simtind/ergoducks/keyboard-layout.png

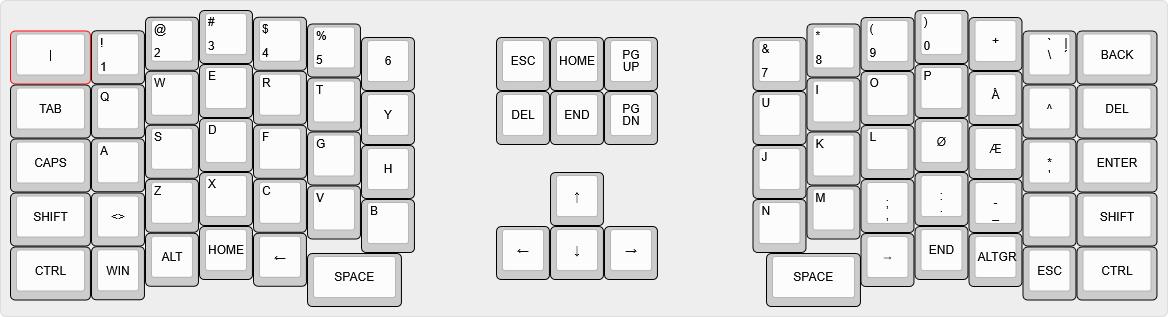
keyboard-layout.png
