simtind/ergoducks/hardware/controller/ergoducks.step

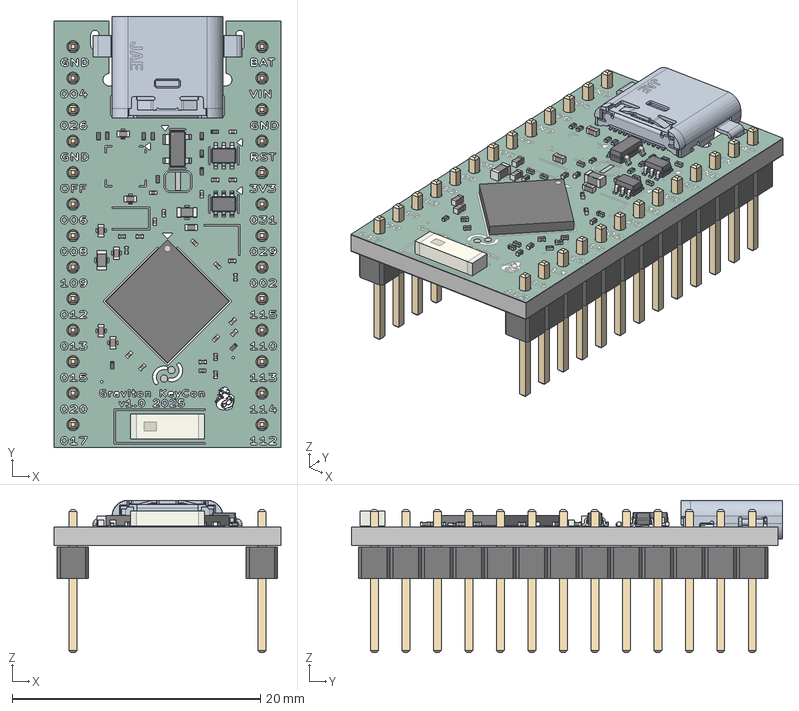
[picture p2: CAD file, 2025-09-15]
hardware/controller/ergoducks.step
18.3 x 34.8 x 12.3 mm
R_0201_0603Metric x 11
C_0201_0603Metric x 20
C_0402_1005Metric x 6
L_0603_1608Metric x 2
L_0201_0603Metric x 3
SOT-363_SC-70-6 x 2
Johanson_2450AT43F0100
SOT-143
Nordic_AQFN-73-1EP_7x7mm_P0.5mm
L_0402_1005Metric
dx07b024jj1r1500
PinHeader_1x13_P2.54mm_Vertical x 2
ergoducks_controller_silkscreen
ergoducks_controller_soldermask
ergoducks_controller_PCB
