simtind/ergoducks/hardware/keyboard_right/ergoducks_keyboard_right.kicad_pcb

## KiCad design hardware/keyboard_right/ergoducks_keyboard_right.kicad_pcb (2025-12-31)

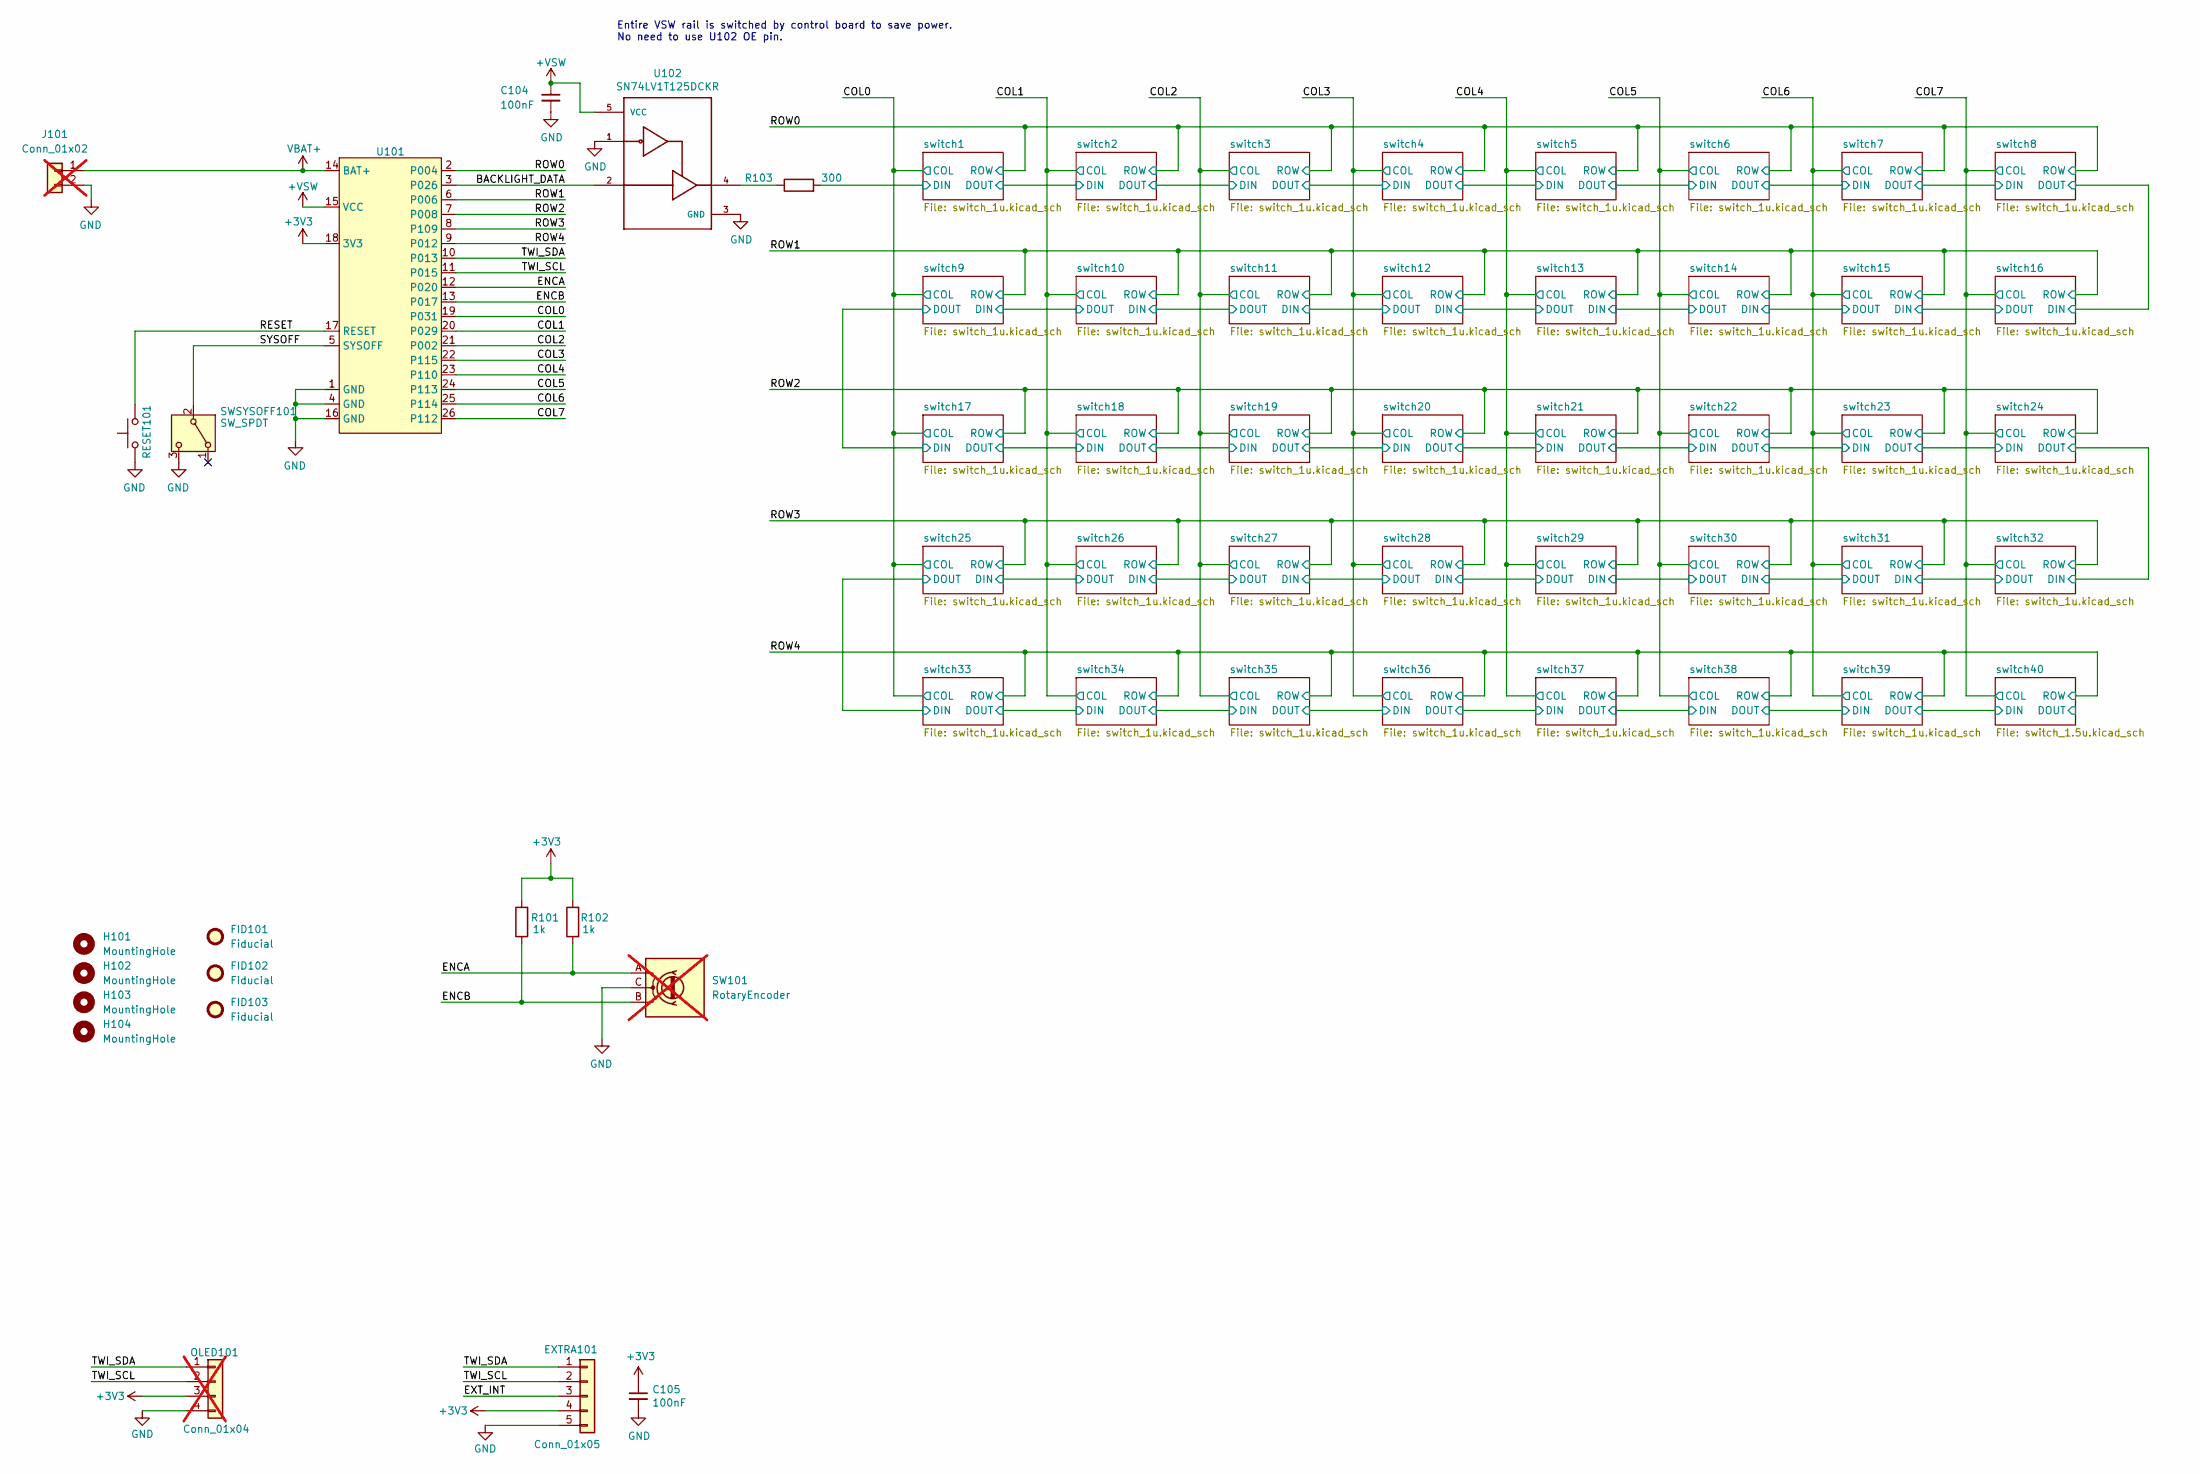
[picture p43: schematic ergoducks_keyboard_right.kicad_sch, ErgoDucks]

Parts:
C104, C105: 100nF; C_0402_1005Metric; Mouser partno 187-CL10B104JB8NNNC
EXTRA101: Conn_01x05; PinHeader_1x05_P2.54mm_Vertical
FID101, FID102, FID103: Fiducial; Fiducial_0.5mm_Mask1mm
H101, H102, H103, H104: MountingHole; MountingHole_2.2mm_M2
J101: Conn_01x02; JST_PH_S2B-PH-K_1x02_P2.00mm_Horizontal; not fitted
OLED101: Conn_01x04; PinHeader_1x04_P2.54mm_Vertical; not fitted
R101, R102: 1k; R_0603_1608Metric_Pad0.98x0.95mm_HandSolder; Mouser partno 667-ERJ-H3ED3000V
R103: 300; R_0603_1608Metric_Pad0.98x0.95mm_HandSolder; Mouser partno 667-ERJ-H3ED3000V
RESET101: SW_Push; SW_SPST_B3U-1000P-B; LCSC C561515
SW101: RotaryEncoder; RotaryEncoder_Alps_EC11E-Switch_Vertical_H20mm_MountingHoles; not fitted
SWSYSOFF101: SW_SPDT; SW_SPDT_CK_JS102011SAQN; LCSC C221660
U101: graviton-keycon
U102: SN74LV1T125DCKR; SOT-23-5; Mouser partno 595-SN74LV1T125DCKR

Connections:
+3V3: C105.1, EXTRA101.4, OLED101.3, R101.2, R102.2, U101.18 (3V3)
+VSW: C104.1, U101.15 (VCC), U102.5 (VCC); also elsewhere on the board
/BACKLIGHT_DATA: U101.3 (P026), U102.2
/COL0: U101.19 (P031); also elsewhere on the board
/COL1: U101.20 (P029); also elsewhere on the board
/COL2: U101.21 (P002); also elsewhere on the board
/COL3: U101.22 (P115); also elsewhere on the board
/COL4: U101.23 (P110); also elsewhere on the board
/COL5: U101.24 (P113); also elsewhere on the board
/COL6: U101.25 (P114); also elsewhere on the board
/COL7: U101.26 (P112); also elsewhere on the board
/ENCA: R102.1, SW101.A, U101.12 (P020)
/ENCB: R101.1, SW101.B, U101.13 (P017)
/EXT_INT: EXTRA101.3
/RESET: RESET101.1, U101.17 (RESET)
/ROW0: U101.2 (P004); also elsewhere on the board
/ROW1: U101.6; also elsewhere on the board
/ROW2: U101.7 (P008); also elsewhere on the board
/ROW3: U101.8 (P109); also elsewhere on the board
/ROW4: U101.9 (P012); also elsewhere on the board
/SYSOFF: SWSYSOFF101.2 (B), U101.5 (SYSOFF)
/TWI_SCL: EXTRA101.2, OLED101.2, U101.11 (P015)
/TWI_SDA: EXTRA101.1, OLED101.1, U101.10 (P013)
/switch1/DIN: R103.2; also elsewhere on the board
GND: C104.2, C105.2, EXTRA101.5, J101.2, OLED101.4, RESET101.2, SW101.C, SWSYSOFF101.3 (C), U101.1 (GND), U101.4 (GND), U101.16 (GND), U102.1, U102.3 (GND); also elsewhere on the board
unnamed: R103.1, U102.4
VBAT+: J101.1, U101.14 (BAT+)

Notes on the sheet:
Entire VSW rail is switched by control board to save power. No need to use U102 OE pin.

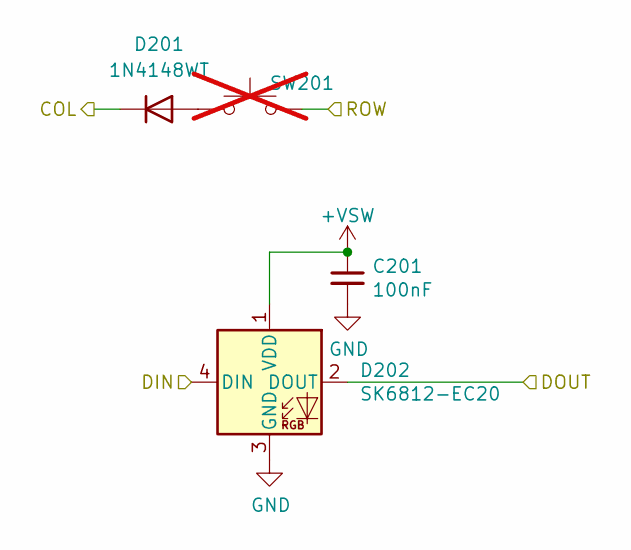
[picture p44: schematic switch_1u.kicad_sch]

Parts:
C201: 100nF; C_0402_1005Metric; Mouser partno 187-CL10B104JB8NNNC
D201: 1N4148WT; D_SOD-523; LCSC C27748
D202: SK6812-EC20; sk6812-ec20; Digikey partno 1528-4960-ND
SW201: SW_Hotswap_Kailh_Choc_V1V2_1.00u; Mouser partno 540-MX1A-G1NA; not fitted

Connections:
+VSW: C201.1, D202.1 (VDD); also elsewhere on the board
/COL0: D201.1 (K); also elsewhere on the board
/ROW0: SW201.2; also elsewhere on the board
/switch1/DIN: D202.4 (DIN); also elsewhere on the board
/switch1/DOUT: D202.2 (DOUT); also elsewhere on the board
GND: C201.2, D202.3 (GND); also elsewhere on the board
unnamed: D201.2 (A), SW201.1

Parts of its further copies:
C301, C401, C501, C601, C701, C801, C901, C1001, C1101, C1201, C1301, C1401, C1501, C1601, C1701, C1801, C1901, C2001, C2101, C2201, C2301, C2401, C2501, C2601, C2701, C2801, C2901, C3001, C3101, C3201, C3301, C3401, C3501, C3601, C3701, C3801, C3901, C4001: 100nF; C_0402_1005Metric; Mouser partno 187-CL10B104JB8NNNC
D301, D401, D501, D601, D701, D801, D901, D1001, D1101, D1201, D1301, D1401, D1501, D1601, D1701, D1801, D1901, D2001, D2101, D2201, D2301, D2401, D2501, D2601, D2701, D2801, D2901, D3001, D3101, D3201, D3301, D3401, D3501, D3601, D3701, D3801, D3901, D4001: 1N4148WT; D_SOD-523; LCSC C27748
D302, D402, D502, D602, D702, D802, D902, D1002, D1102, D1202, D1302, D1402, D1502, D1602, D1702, D1802, D1902, D2002, D2102, D2202, D2302, D2402, D2502, D2602, D2702, D2802, D2902, D3002, D3102, D3202, D3302, D3402, D3502, D3602, D3702, D3802, D3902, D4002: SK6812-EC20; sk6812-ec20; Digikey partno 1528-4960-ND
SW301, SW401, SW501, SW601, SW701, SW801, SW901, SW1001, SW1101, SW1201, SW1301, SW1401, SW1501, SW1601, SW1701, SW1801, SW1901, SW2001, SW2101, SW2201, SW2301, SW2401, SW2501, SW2601, SW2701, SW2801, SW2901, SW3001, SW3101, SW3201, SW3301, SW3401, SW3501, SW3601, SW3701, SW3801, SW3901, SW4001: SW_Hotswap_Kailh_Choc_V1V2_1.00u; Mouser partno 540-MX1A-G1NA; not fitted

Connections of its further copies:
+VSW: C301.1, C401.1, C501.1, C601.1, C701.1, C801.1, C901.1, C1001.1, C1101.1, C1201.1, C1301.1, C1401.1, C1501.1, C1601.1, C1701.1, C1801.1, C1901.1, C2001.1, C2101.1, C2201.1, C2301.1, C2401.1, C2501.1, C2601.1, C2701.1, C2801.1, C2901.1, C3001.1, C3101.1, C3201.1, C3301.1, C3401.1, C3501.1, C3601.1, C3701.1, C3801.1, C3901.1, C4001.1, D302.1 (VDD), D402.1 (VDD), D502.1 (VDD), D602.1 (VDD), D702.1 (VDD), D802.1 (VDD), D902.1 (VDD), D1002.1 (VDD), D1102.1 (VDD), D1202.1 (VDD), D1302.1 (VDD), D1402.1 (VDD), D1502.1 (VDD), D1602.1 (VDD), D1702.1 (VDD), D1802.1 (VDD), D1902.1 (VDD), D2002.1 (VDD), D2102.1 (VDD), D2202.1 (VDD), D2302.1 (VDD), D2402.1 (VDD), D2502.1 (VDD), D2602.1 (VDD), D2702.1 (VDD), D2802.1 (VDD), D2902.1 (VDD), D3002.1 (VDD), D3102.1 (VDD), D3202.1 (VDD), D3302.1 (VDD), D3402.1 (VDD), D3502.1 (VDD), D3602.1 (VDD), D3702.1 (VDD), D3802.1 (VDD), D3902.1 (VDD), D4002.1 (VDD); also elsewhere on the board
/COL0: D1001.1 (K), D1801.1 (K), D2601.1 (K), D3401.1 (K); also elsewhere on the board
/COL1: D301.1 (K), D1101.1 (K), D1901.1 (K), D2701.1 (K), D3501.1 (K); also elsewhere on the board
/COL2: D401.1 (K), D1201.1 (K), D2001.1 (K), D2801.1 (K), D3601.1 (K); also elsewhere on the board
/COL3: D501.1 (K), D1301.1 (K), D2101.1 (K), D2901.1 (K), D3701.1 (K); also elsewhere on the board
/COL4: D601.1 (K), D1401.1 (K), D2201.1 (K), D3001.1 (K), D3801.1 (K); also elsewhere on the board
/COL5: D701.1 (K), D1501.1 (K), D2301.1 (K), D3101.1 (K), D3901.1 (K); also elsewhere on the board
/COL6: D801.1 (K), D1601.1 (K), D2401.1 (K), D3201.1 (K), D4001.1 (K); also elsewhere on the board
/COL7: D901.1 (K), D1701.1 (K), D2501.1 (K), D3301.1 (K); also elsewhere on the board
/ROW0: SW301.2, SW401.2, SW501.2, SW601.2, SW701.2, SW801.2, SW901.2; also elsewhere on the board
/ROW1: SW1001.2, SW1101.2, SW1201.2, SW1301.2, SW1401.2, SW1501.2, SW1601.2, SW1701.2; also elsewhere on the board
/ROW2: SW1801.2, SW1901.2, SW2001.2, SW2101.2, SW2201.2, SW2301.2, SW2401.2, SW2501.2; also elsewhere on the board
/ROW3: SW2601.2, SW2701.2, SW2801.2, SW2901.2, SW3001.2, SW3101.2, SW3201.2, SW3301.2; also elsewhere on the board
/ROW4: SW3401.2, SW3501.2, SW3601.2, SW3701.2, SW3801.2, SW3901.2, SW4001.2; also elsewhere on the board
/switch1/DOUT: D302.4 (DIN); also elsewhere on the board
/switch2/DOUT: D302.2 (DOUT), D402.4 (DIN)
/switch3/DOUT: D402.2 (DOUT), D502.4 (DIN)
/switch4/DOUT: D502.2 (DOUT), D602.4 (DIN)
/switch5/DOUT: D602.2 (DOUT), D702.4 (DIN)
/switch6/DOUT: D702.2 (DOUT), D802.4 (DIN)
/switch7/DOUT: D802.2 (DOUT), D902.4 (DIN)
/switch10/DIN: D1102.4 (DIN), D1202.2 (DOUT)
/switch10/DOUT: D1002.4 (DIN), D1102.2 (DOUT)
/switch11/DIN: D1202.4 (DIN), D1302.2 (DOUT)
/switch12/DIN: D1302.4 (DIN), D1402.2 (DOUT)
/switch13/DIN: D1402.4 (DIN), D1502.2 (DOUT)
/switch14/DIN: D1502.4 (DIN), D1602.2 (DOUT)
/switch15/DIN: D1602.4 (DIN), D1702.2 (DOUT)
/switch16/DIN: D902.2 (DOUT), D1702.4 (DIN)
/switch17/DIN: D1002.2 (DOUT), D1802.4 (DIN)
/switch17/DOUT: D1802.2 (DOUT), D1902.4 (DIN)
/switch18/DOUT: D1902.2 (DOUT), D2002.4 (DIN)
/switch19/DOUT: D2002.2 (DOUT), D2102.4 (DIN)
/switch20/DOUT: D2102.2 (DOUT), D2202.4 (DIN)
/switch21/DOUT: D2202.2 (DOUT), D2302.4 (DIN)
/switch22/DOUT: D2302.2 (DOUT), D2402.4 (DIN)
/switch23/DOUT: D2402.2 (DOUT), D2502.4 (DIN)
/switch24/DOUT: D2502.2 (DOUT), D3302.4 (DIN)
/switch25/DIN: D2602.4 (DIN), D2702.2 (DOUT)
/switch25/DOUT: D2602.2 (DOUT), D3402.4 (DIN)
/switch26/DIN: D2702.4 (DIN), D2802.2 (DOUT)
/switch27/DIN: D2802.4 (DIN), D2902.2 (DOUT)
/switch28/DIN: D2902.4 (DIN), D3002.2 (DOUT)
/switch29/DIN: D3002.4 (DIN), D3102.2 (DOUT)
/switch30/DIN: D3102.4 (DIN), D3202.2 (DOUT)
/switch31/DIN: D3202.4 (DIN), D3302.2 (DOUT)
/switch33/DOUT: D3402.2 (DOUT), D3502.4 (DIN)
/switch34/DOUT: D3502.2 (DOUT), D3602.4 (DIN)
/switch35/DOUT: D3602.2 (DOUT), D3702.4 (DIN)
/switch36/DOUT: D3702.2 (DOUT), D3802.4 (DIN)
/switch37/DOUT: D3802.2 (DOUT), D3902.4 (DIN)
/switch38/DOUT: D3902.2 (DOUT), D4002.4 (DIN)
/switch39/DOUT: D4002.2 (DOUT); also elsewhere on the board
GND: C301.2, C401.2, C501.2, C601.2, C701.2, C801.2, C901.2, C1001.2, C1101.2, C1201.2, C1301.2, C1401.2, C1501.2, C1601.2, C1701.2, C1801.2, C1901.2, C2001.2, C2101.2, C2201.2, C2301.2, C2401.2, C2501.2, C2601.2, C2701.2, C2801.2, C2901.2, C3001.2, C3101.2, C3201.2, C3301.2, C3401.2, C3501.2, C3601.2, C3701.2, C3801.2, C3901.2, C4001.2, D302.3 (GND), D402.3 (GND), D502.3 (GND), D602.3 (GND), D702.3 (GND), D802.3 (GND), D902.3 (GND), D1002.3 (GND), D1102.3 (GND), D1202.3 (GND), D1302.3 (GND), D1402.3 (GND), D1502.3 (GND), D1602.3 (GND), D1702.3 (GND), D1802.3 (GND), D1902.3 (GND), D2002.3 (GND), D2102.3 (GND), D2202.3 (GND), D2302.3 (GND), D2402.3 (GND), D2502.3 (GND), D2602.3 (GND), D2702.3 (GND), D2802.3 (GND), D2902.3 (GND), D3002.3 (GND), D3102.3 (GND), D3202.3 (GND), D3302.3 (GND), D3402.3 (GND), D3502.3 (GND), D3602.3 (GND), D3702.3 (GND), D3802.3 (GND), D3902.3 (GND), D4002.3 (GND); also elsewhere on the board
unnamed: D301.2 (A), SW301.1
unnamed: D401.2 (A), SW401.1
unnamed: D501.2 (A), SW501.1
unnamed: D601.2 (A), SW601.1
unnamed: D701.2 (A), SW701.1
unnamed: D801.2 (A), SW801.1
unnamed: D901.2 (A), SW901.1
unnamed: D1001.2 (A), SW1001.1
unnamed: D1101.2 (A), SW1101.1
unnamed: D1201.2 (A), SW1201.1
unnamed: D1301.2 (A), SW1301.1
unnamed: D1401.2 (A), SW1401.1
unnamed: D1501.2 (A), SW1501.1
unnamed: D1601.2 (A), SW1601.1
unnamed: D1701.2 (A), SW1701.1
unnamed: D1801.2 (A), SW1801.1
unnamed: D1901.2 (A), SW1901.1
unnamed: D2001.2 (A), SW2001.1
unnamed: D2101.2 (A), SW2101.1
unnamed: D2201.2 (A), SW2201.1
unnamed: D2301.2 (A), SW2301.1
unnamed: D2401.2 (A), SW2401.1
unnamed: D2501.2 (A), SW2501.1
unnamed: D2601.2 (A), SW2601.1
unnamed: D2701.2 (A), SW2701.1
unnamed: D2801.2 (A), SW2801.1
unnamed: D2901.2 (A), SW2901.1
unnamed: D3001.2 (A), SW3001.1
unnamed: D3101.2 (A), SW3101.1
unnamed: D3201.2 (A), SW3201.1
unnamed: D3301.2 (A), SW3301.1
unnamed: D3401.2 (A), SW3401.1
unnamed: D3501.2 (A), SW3501.1
unnamed: D3601.2 (A), SW3601.1
unnamed: D3701.2 (A), SW3701.1
unnamed: D3801.2 (A), SW3801.1
unnamed: D3901.2 (A), SW3901.1
unnamed: D4001.2 (A), SW4001.1

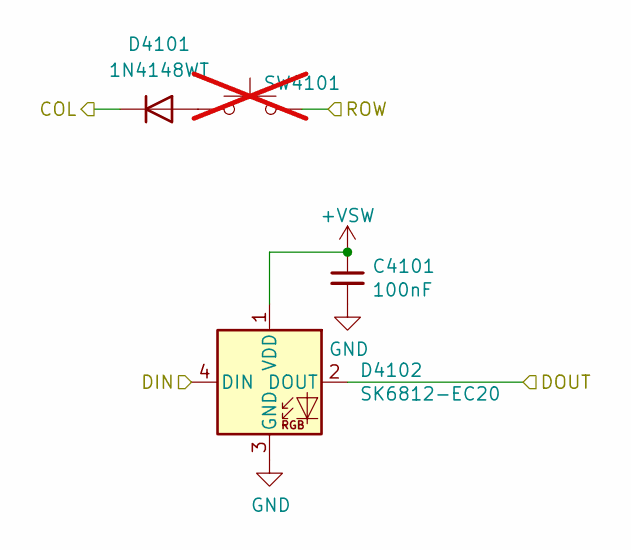
[picture p45: schematic switch_1.5u.kicad_sch]

Parts:
C4101: 100nF; C_0402_1005Metric; Mouser partno 187-CL10B104JB8NNNC
D4101: 1N4148WT; D_SOD-523; LCSC C27748
D4102: SK6812-EC20; sk6812-ec20; Digikey partno 1528-4960-ND
SW4101: SW_Hotswap_Kailh_Choc_V1V2_1.50u; Mouser partno 540-MX1A-G1NA; not fitted

Connections:
+VSW: C4101.1, D4102.1 (VDD); also elsewhere on the board
/COL7: D4101.1 (K); also elsewhere on the board
/ROW4: SW4101.2; also elsewhere on the board
/switch39/DOUT: D4102.4 (DIN); also elsewhere on the board
/switch40/DOUT: D4102.2 (DOUT)
GND: C4101.2, D4102.3 (GND); also elsewhere on the board
unnamed: D4101.2 (A), SW4101.1

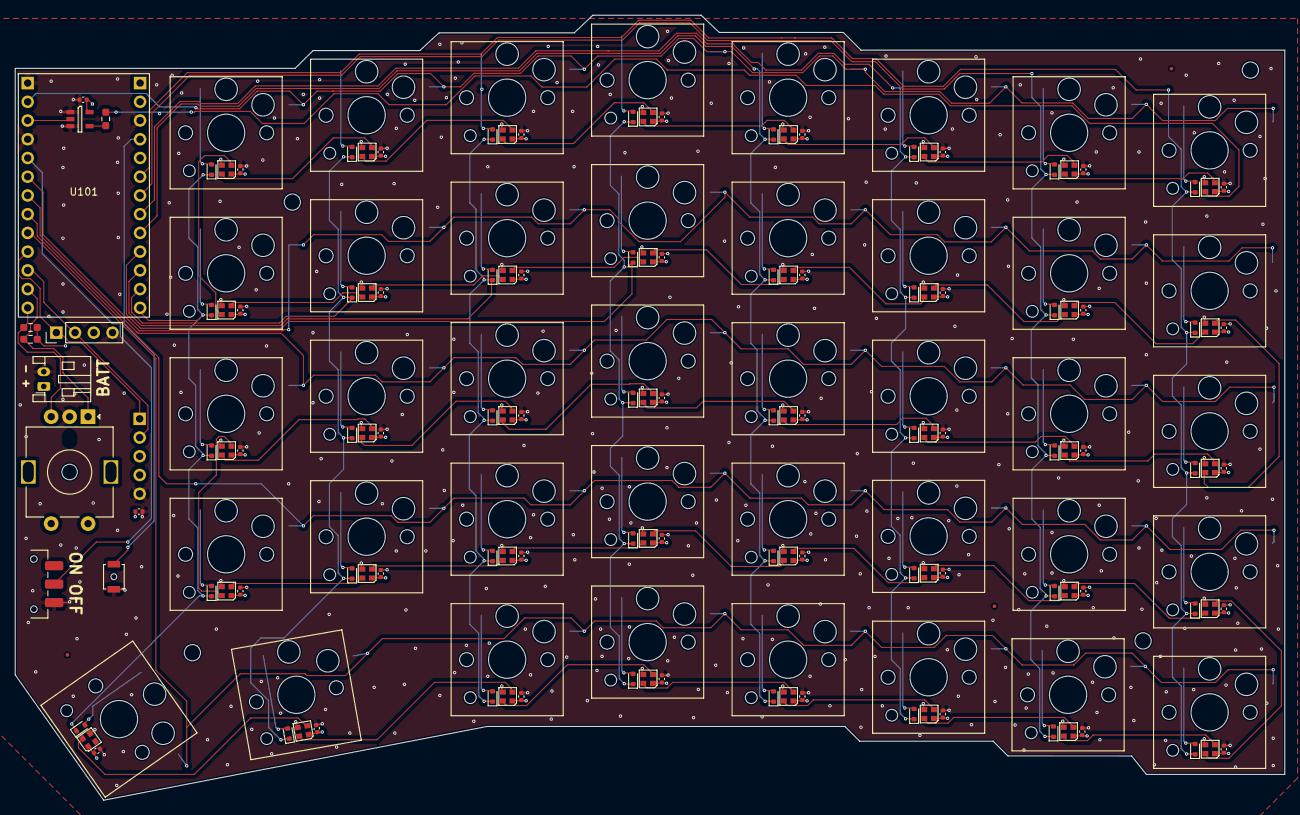
[picture p46: board ergoducks_keyboard_right.kicad_pcb from above]

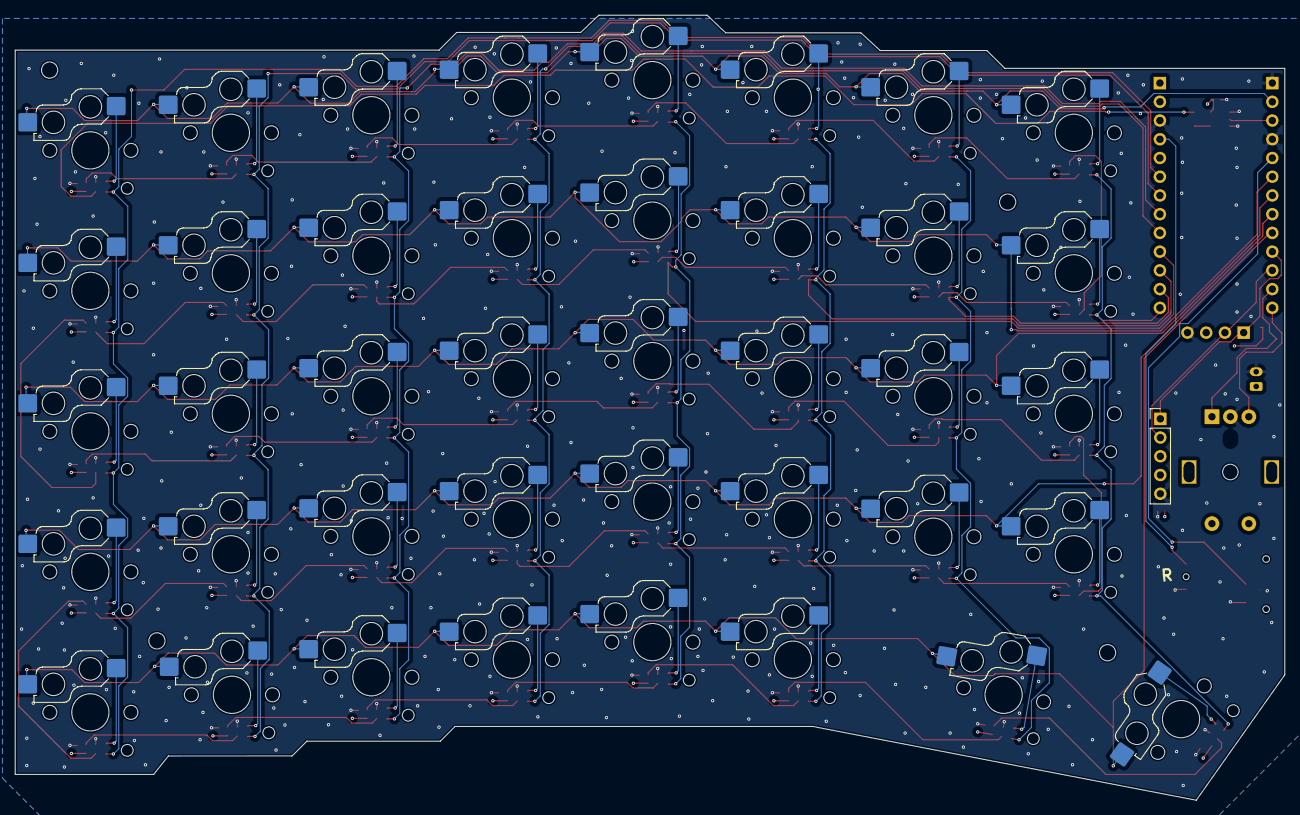
[picture p47: board ergoducks_keyboard_right.kicad_pcb from below]

Board: 4 copper layers, 172.1 x 106.4 mm, 180 parts (2 on the bottom side), 105 nets.
