simtind/ergoducks/hardware/controller/ergoducks_controller.kicad_pcb

## KiCad design hardware/controller/ergoducks_controller.kicad_pcb (2025-09-15)

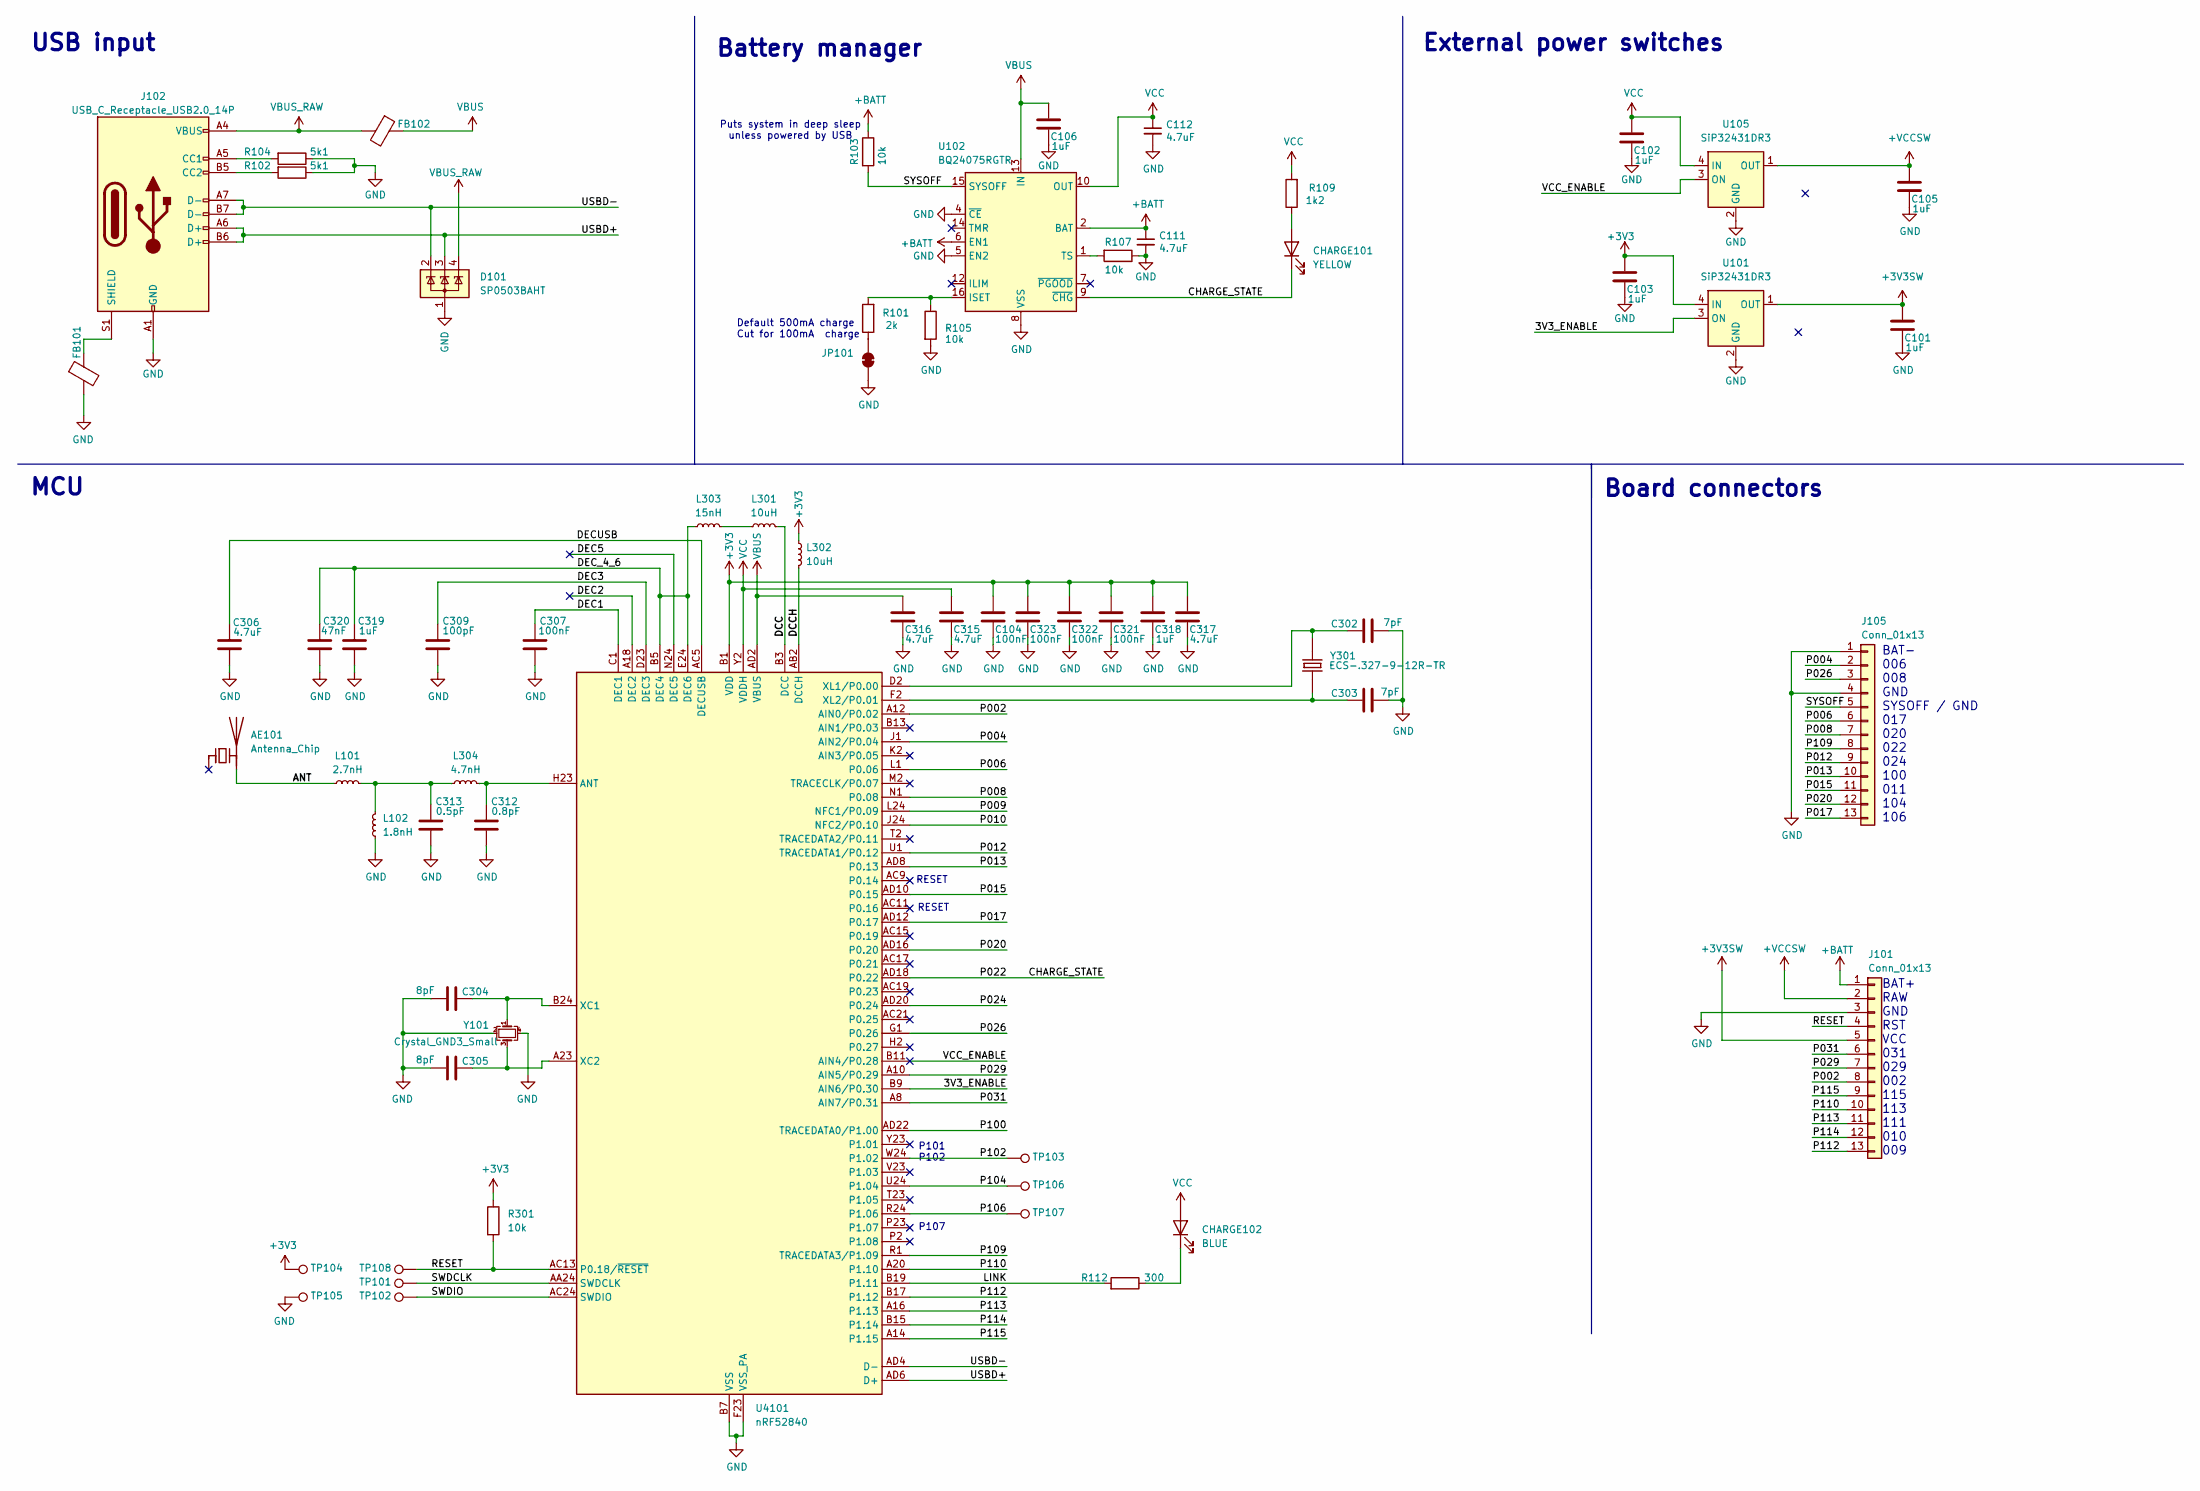
[picture p48: schematic ergoducks_controller.kicad_sch, ErgoDucks]

Parts:
AE101: Antenna_Chip; Johanson_2450AT43F0100_wwithpads_cortyard; Part Number 2450AT43B100E; LCSC C2917721
C101, C102, C103, C105, C106, C318, C319: 1uF; C_0201_0603Metric; Part Number GRM033R61A105ME44D; LCSC C76935
C104, C307, C321, C322, C323: 100nF; C_0201_0603Metric; Part Number GRM033Z71C104KE14D; LCSC C668346
C111, C112: 4.7uF; C_0402_1005Metric; Mouser partno 187-CL10A475KQ8NNNC
C302, C303: 7pF; C_0201_0603Metric; Part Number GRM0335C1H7R0BA01D; LCSC C161436
C304, C305: 8pF; C_0201_0603Metric; Part Number GRM0335C1H8R0BA01D; LCSC C237417
C306, C315, C316, C317: 4.7uF; C_0402_1005Metric; Part Number GRM155R61E475ME15DGRM155R61E475ME15D; LCSC C2858031
C309: 100pF; C_0201_0603Metric; Part Number GRM0335C1H101JA01D; LCSC C76922
C312: 0.8pF; C_0201_0603Metric; Part Number GRM0335C1HR80WA01D; LCSC C385012
C313: 0.5pF; C_0201_0603Metric; Part Number GRM0335C1HR50BA01D; LCSC C85920
C320: 47nF; C_0201_0603Metric; Part Number GRM033C80J473KE19D; LCSC C782148
CHARGE101: YELLOW; D_0402_1005Metric; Part Number XL-1005UYC; LCSC C25503856
CHARGE102: BLUE; D_0402_1005Metric; Part Number SZYY0402B; LCSC C434447
D101: SP0503BAHT; SOT-143; Part Number SP0503BAHTG; LCSC C7074
FB101, FB102: 120R/0.55A; R_0201_0603Metric; Mouser partno 673-PE-0603PFB121ST
J101, J105: Conn_01x13; PinHeader_1x13_P2.54mm_Vertical
J102: USB_C_Receptacle_USB2.0_14P; JAE_DX07B024JJ2R1500; Part Number DX07B024JJ1R1500; LCSC C2977280
JP101: Cut for 100mA charge; SolderJumper-2_P1mm_Bridged_RoundedPad0.8x1mm
L101: 2.7nH; L_0201_0603Metric; Part Number LQP03TN2N7B02D; LCSC C98043
L102: 1.8nH; L_0201_0603Metric; Part Number LQP03TN1N8B02D; LCSC C98040
L301, L302: 10uH; L_0603_1608Metric; Part Number LQM18FN100M00D; LCSC C86083
L303: 15nH; L_0402_1005Metric; Part Number LQG15HS15NJ02D; LCSC C86059
L304: 4.7nH; L_0201_0603Metric; Part Number LQP03HQ4N7H02D; LCSC C237443
R101: 2k; R_0201_0603Metric; Mouser partno 667-ERJ-H3ED3000V
R102, R104: 5k1; R_0201_0603Metric; Mouser partno 603-RC0603JR-075K1L
R103, R105, R107: 10k; R_0201_0603Metric; Mouser partno 667-ERJ-H3ED1002V
R109: 1k2; R_0201_0603Metric; Mouser partno 667-ERJ-H3ED3000V
R112: 300; R_0201_0603Metric; Mouser partno 667-ERJ-H3ED3000V
R301: 10k; R_0201_0603Metric; Part Number RC0201FR-0710KL; LCSC C106225
TP101, TP108: SWDCLK; TestPoint_Pad_D1.0mm
TP102: SWDIO; TestPoint_Pad_D1.0mm
TP103, TP104, TP106, TP107: 3V3; TestPoint_Pad_D1.0mm
TP105: GND; TestPoint_Pad_D1.0mm
U101, U105: SiP32431DR3; SOT-363_SC-70-6; Part Number SIP32431DR3-T1GE3; LCSC C141606
U102: BQ24075RGTR; VQFN-16-1EP_3x3mm_P0.5mm_EP1.6x1.6mm; Mouser partno 595-BQ24079TRGTR; Digikey partno 296-BQ24079QWRGTRQ1CT-ND
U4101: nRF52840; Nordic_AQFN-73-1EP_7x7mm_P0.5mm; Part Number NRF52840-QIAA-R; LCSC C190794
Y101: Crystal_GND3_Small; Crystal_SMD_SeikoEpson_FA128-4Pin_2.0x1.6mm; Part Number Q22FA12800025; LCSC C187794
Y301: ECS-.327-9-12R-TR; Crystal_SMD_2012-2Pin_2.0x1.2mm_HandSoldering; Mouser partno 520-.327-9-12R-T

Connections:
+3V3: C103.2, C104.2, C317.2, C318.2, C321.2, C322.2, C323.2, L302.1, R301.1, TP104.1, U101.4 (IN), U4101.A22 (VDD), U4101.AD14 (VDD), U4101.AD23 (VDD), U4101.B1 (VDD), U4101.W1 (VDD)
+3V3SW: C101.2, J101.5, U101.1 (OUT)
+BATT: C111.1, J101.1, R103.1, U102.2 (BAT), U102.3 (BAT), U102.6 (EN1)
+VCCSW: C105.2, J101.2, U105.1 (OUT)
/3V3_ENABLE: U101.3 (ON), U4101.B9 (AIN6/P0.30)
/ANT: AE101.2 (PCB_Trace), L101.1
/CHARGE_STATE: CHARGE101.1 (K), U102.9 (~CHG), U4101.AD18 (P0.22)
/DCC: L301.2, U4101.B3 (DCC)
/DCCH: L302.2, U4101.AB2 (DCCH)
/DEC1: C307.2, U4101.C1 (DEC1)
/DEC2: U4101.A18 (DEC2)
/DEC3: C309.2, U4101.D23 (DEC3)
/DEC5: U4101.N24 (DEC5)
/DECUSB: C306.2, U4101.AC5 (DECUSB)
/DEC_4_6: C319.2, C320.2, L303.1, U4101.B5 (DEC4), U4101.E24 (DEC6)
/LINK: R112.2, U4101.B19 (P1.11)
/P002: J101.8, U4101.A12 (AIN0/P0.02)
/P004: J105.2, U4101.J1 (AIN2/P0.04)
/P006: J105.6, U4101.L1 (P0.06)
/P008: J105.7, U4101.N1 (P0.08)
/P009: U4101.L24 (NFC1/P0.09)
/P010: U4101.J24 (NFC2/P0.10)
/P012: J105.9, U4101.U1 (TRACEDATA1/P0.12)
/P013: J105.10, U4101.AD8 (P0.13)
/P015: J105.11, U4101.AD10 (P0.15)
/P017: J105.13, U4101.AD12 (P0.17)
/P020: J105.12, U4101.AD16 (P0.20)
/P024: U4101.AD20 (P0.24)
/P026: J105.3, U4101.G1 (P0.26)
/P029: J101.7, U4101.A10 (AIN5/P0.29)
/P031: J101.6, U4101.A8 (AIN7/P0.31)
/P100: U4101.AD22 (TRACEDATA0/P1.00)
/P102: TP103.1, U4101.W24 (P1.02)
/P104: TP106.1, U4101.U24 (P1.04)
/P106: TP107.1, U4101.R24 (P1.06)
/P109: J105.8, U4101.R1 (TRACEDATA3/P1.09)
/P110: J101.10, U4101.A20 (P1.10)
/P112: J101.13, U4101.B17 (P1.12)
/P113: J101.11, U4101.A16 (P1.13)
/P114: J101.12, U4101.B15 (P1.14)
/P115: J101.9, U4101.A14 (P1.15)
/RESET: J101.4, R301.2, TP108.1, U4101.AC13 (P0.18/~RESET)
/SWDCLK: TP101.1, U4101.AA24 (SWDCLK)
/SWDIO: TP102.1, U4101.AC24 (SWDIO)
/SYSOFF: J105.5, R103.2, U102.15 (SYSOFF)
/USBD+: D101.3 (K), J102.A6 (D+), J102.B6 (D+), U4101.AD6 (D+)
/USBD-: D101.2 (K), J102.A7 (D-), J102.B7 (D-), U4101.AD4 (D-)
/VCC_ENABLE: U105.3 (ON), U4101.B11 (AIN4/P0.28)
GND: C101.1, C102.1, C103.1, C104.1, C105.1, C106.1, C111.2, C112.2, C302.2, C303.2, C304.2, C305.2, C306.1, C307.1, C309.1, C312.1, C313.1, C315.1, C316.1, C317.1, C318.1, C319.1, C320.1, C321.1, C322.1, C323.1, D101.1 (A), FB101.2, J101.3, J102.A1 (GND), J102.A12 (GND), J102.B1 (GND), J102.B12 (GND), J105.1, J105.4, JP101.1 (A), L102.1, R102.1, R104.1, R105.2, R107.1, TP105.1, U101.2 (GND), U101.5 (GND), U102.4 (~CE), U102.5 (EN2), U102.8 (VSS), U102.17 (VSS), U105.2 (GND), U105.5 (GND), U4101.B7 (VSS), U4101.EP (VSS), U4101.F23 (VSS_PA), Y101.2, Y101.4
unnamed: C313.2, L101.2, L102.2, L304.1
unnamed: CHARGE101.2 (A), R109.1
unnamed: CHARGE102.1 (K), R112.1
unnamed: J102.A5 (CC1), R104.2
unnamed: J102.B5 (CC2), R102.2
unnamed: FB101.1, J102.S1 (SHIELD)
unnamed: JP101.2 (B), R101.1
unnamed: L301.1, L303.2
unnamed: R101.2, R105.1, U102.16 (ISET)
unnamed: R107.2, U102.1 (TS)
unnamed: C312.2, L304.2, U4101.H23 (ANT)
unnamed: C304.1, U4101.B24 (XC1), Y101.1
unnamed: C305.1, U4101.A23 (XC2), Y101.3
unnamed: C302.1, U4101.D2 (XL1/P0.00), Y301.1
unnamed: C303.1, U4101.F2 (XL2/P0.01), Y301.2
VBUS: C106.2, C316.2, FB102.1, U102.13 (IN), U4101.AD2 (VBUS)
VBUS_RAW: D101.4 (K), FB102.2, J102.A4 (VBUS), J102.A9 (VBUS), J102.B4 (VBUS), J102.B9 (VBUS)
VCC: C102.2, C112.1, C315.2, CHARGE102.2 (A), R109.2, U102.10 (OUT), U102.11 (OUT), U105.4 (IN), U4101.Y2 (VDDH)

Notes on the sheet:
USB input
BAT+ RAW GND RST VCC 031 029 002 115 113 111 010 009
Default 500mA charge Cut for 100mA charge
External power switches
P101 P102
MCU
P107
RESET
Battery manager
BAT- 006 008 GND SYSOFF / GND 017 020 022 024 100 011 104 106
Puts system in deep sleep unless powered by USB
Board connectors

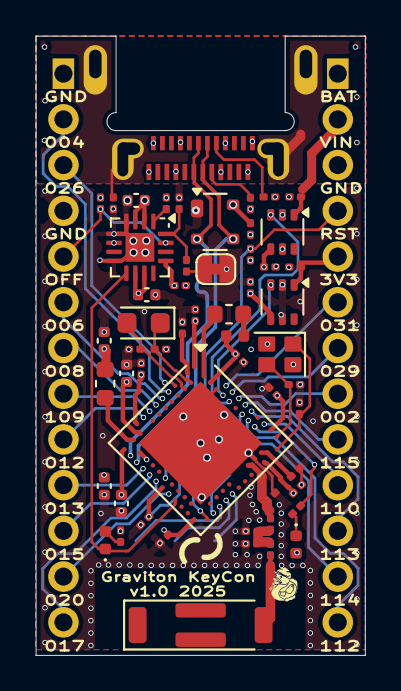
[picture p49: board ergoducks_controller.kicad_pcb from above]

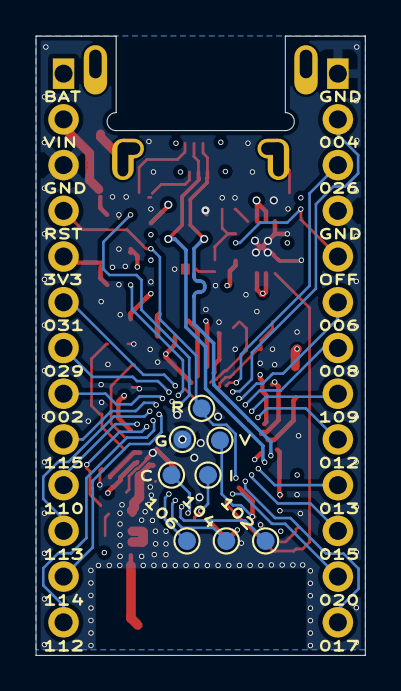
[picture p50: board ergoducks_controller.kicad_pcb from below]

Board: 6 copper layers, 18.3 x 34.4 mm, 65 parts (10 on the bottom side), 61 nets.
