simtind/ergoducks/(commit log)

2025-08-08 Check in project
    [backlight.kicad_sch, backlight.sch, ergoducks.kicad_sch, ergoducks.sch, ledmatrix.sch, mcu.sch, power.kicad_sch, power.sch]
2025-08-08 Add auto-saved version of pcb.
2025-09-15 Start rev 2
    [backlight.kicad_sch, backlight.sch, ergoducks.kicad_pcb, ergoducks.kicad_sch, ergoducks.sch, ergoducks.step, ergoducks_controller.kicad_pcb, ergoducks_controller.kicad_sch]
2025-12-31 Update after producion of rev 2
    [backlight.kicad_sch, ergoducks_keyboard.kicad_pcb, ergoducks_keyboard_left.kicad_pcb, ergoducks_keyboard_left.kicad_sch, ergoducks_keyboard_right.kicad_pcb, ergoducks_keyboard_right.kicad_sch, mcu.kicad_sch, power.kicad_sch]
2025-12-31 Add sensor bindings
2025-12-31 fix cdc uart
2026-01-01 Fix keyboard pin mapping
2026-01-01 Select correct ws2812 driver
2026-01-02 Increase I2C log level
2026-01-02 Remove ext power handling
2026-01-02 Remove pro micro pin mappings
2026-01-02 Switch to usb logging
2026-01-02 Dump I2C messages
2026-01-03 Make encoders scrollwheels
2026-01-03 Even more beter encoder
2026-05-24 Default-enable external power
2026-05-24 Use external regulators to control load switches instead of zmk
2026-05-24 Set correct pin polarity
2026-05-24 Try using leds?
2026-05-24 Device name
2026-05-24 Enable RGB leds
2026-05-24 Fix righth side pin mapping
2026-05-26 Switch central to right half
